robilkot/PhysPult/PhysPult_cad/Иллюстрации.pdf

# Общий вид конструкции

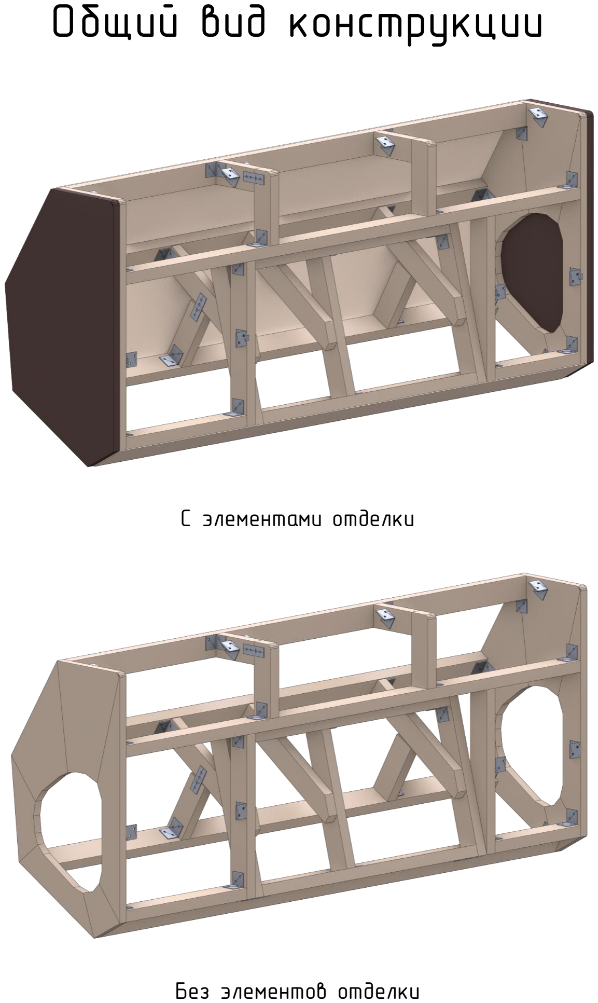
[picture p1: page 1]

С элементами отделки

Без элементов отделки

# Сборка конструкции

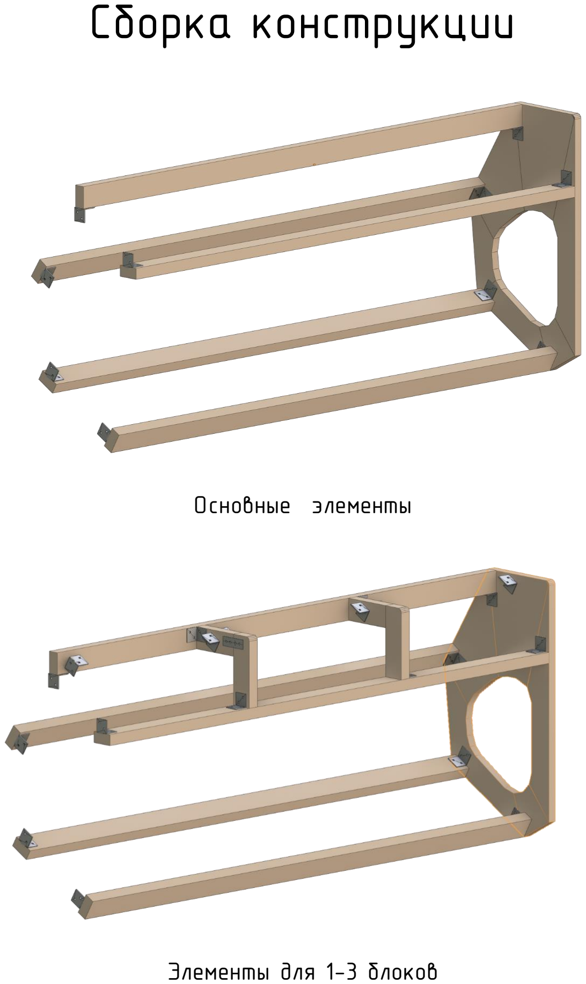
[picture p2: page 2]

Основные элементы

Элементы для 1-3 блоков

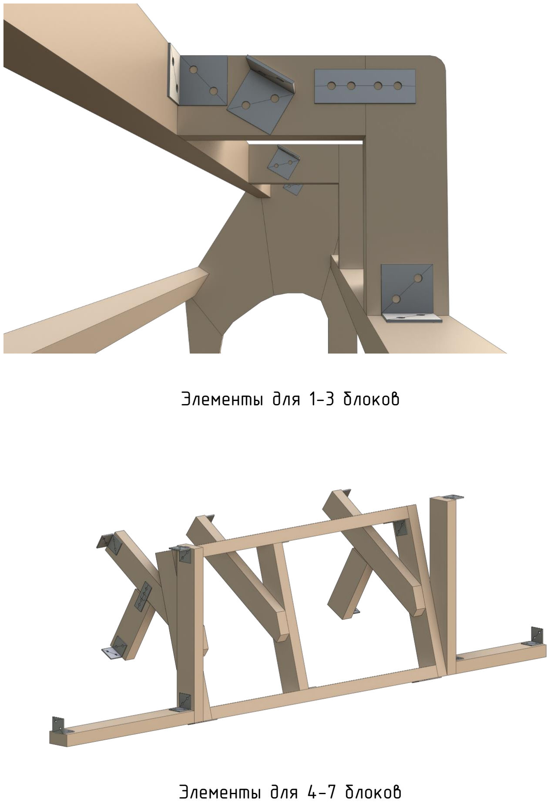
[picture p3: page 3]

Элементы для 1-3 блоков

Элементы для 4-7 блоков

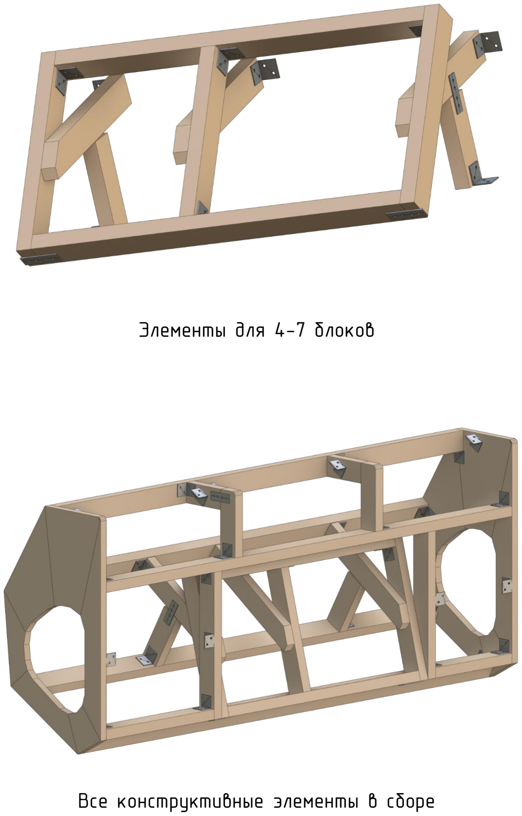
[picture p4: page 4]

Элементы для 4-7 блоков

Все конструктивные элементы в сборе
