robilkot/PhysPult/PhysPult_cad/Manometers.SLDPRT

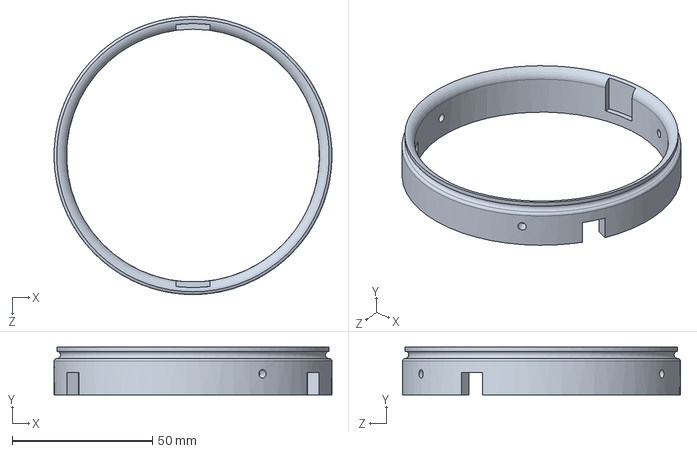
[picture p5: CAD file, 2023-04-17]
PhysPult_cad/Manometers.SLDPRT
99.0 x 17.0 x 99.0 mm
