robilkot/PhysPult/(list of files, cad)

Other CAD files:
PhysPult_cad/PhysPult_frame.blend
PhysPult_cad/PhysPult_manometers.blend
