robilkot/PhysPult/81-717.5_pult_cpp/81-717.5_pult_cpp_config.txt

C:\Program Files (x86)\Steam\steamapps\common\GarrysMod\garrysmod\data\lamps.txt
C:\Program Files (x86)\Steam\steamapps\common\GarrysMod\garrysmod\data\switches.txt
5
9600
