robilkot/PhysPult/(commit log)

2022-12-27 initial commit: arduino sketch, vs solution, table for matching indicators and pins
    [81-717.5_pult_cpp_config.txt, Таблица соответствия.xlsx]
2022-12-27 add SimpleSerial library, add notification about pause
    [syntax_config.txt]
2022-12-27 add arduino sketch
2022-12-27 move init to separate func, add configurable baud rate and frequency, remove enum, enhance arduino sketch
    [81-717.5_pult_cpp_config.txt]
2022-12-28 fix crash on meeting strings with unequal length
    [81-717.5_pult_cpp_config.txt]
2022-12-29 edit arduino sketch to work with registers. adapt c++ medium, refactor
2022-12-31 Оптимизация и рефакторинг кода микроконтроллера, дополнение таблицы соответствия
    [Таблица соответствия.xlsx]
2022-12-31 Реализована функция чтения значений с входных сдвиговых регистров
2023-01-01 Переход от инжектов к считыванию значений по таймеру. Оптимизация, рефакторинг
2023-01-01 Добавлено считывание состояний переключателей из файла. Изменена таблица соответствия
    [Таблица соответствия.xlsx]
2023-01-01 Реализована функция записи состояния переключателей в файл. Изменен формат конфига
    [81-717.5_pult_cpp_config.txt, syntax_config.txt]
2023-01-02 Рефакторинг, синхронизация состояний тумблеров, разделение таблиц кнопок и тумблеров
2023-01-02 Длины строк состояния вынесены в конфиг-файл, возможность задавать собственный конфиг-файл как аргумент при запуске программы
    [physpult_config.txt]
2023-01-02 Изменена структура проекта
    [mappingTable.xlsx, physpult_config.txt, syntax_config.txt]
2023-01-03 Прошивка теперь позволяет подключать регистры к цифровым пинам 1-7
2023-01-03 Рефакторинг
2023-01-04 Добавлена горячая перезагрузка и налажен приём данных с ардуино
    [physpult_config.txt]
2023-01-04 Улучшена горячая перезагрузка
    [physpult_config.txt]
2023-01-05 Наладка отправки данных в обе стороны
2023-01-08 Реализована передача информации по сокетам. Изменен формат конфига.
    [physpult_config.txt]
2023-01-10 Отлажена передача данных по сокетам, рефакторинг
    [physpult_config.txt]
2023-01-17 Рефакторинг, костыль решающий потерянные пакеты на начале работы серийного порта
    [physpult_config.txt]
2023-01-18 Добавлена возможность ставить таймаут приема по серийному порту в миллисекундах. Рефакторинг библиотеки для серийного порта
2023-01-31 Реализован асинхронный приём данных по COM порту
2023-01-31 Незначительные исправления
    [syntax_config.txt]
2023-01-31 Реализована многопоточность для сокетов и серийного порта. Чтение конфига скриптом луа
    [physpult_config.txt]
2023-02-04 Переподключение сокета в случае ошибки
    [physpult_config.txt]
2023-02-04 Передел под ООП
2023-02-07 Исправлены ошибки подключения, связанные с инициализацией объектов SimpleSerial и TcpClient
    [main.cpp]
2023-02-07 Решены проблемы при горячей перезагрузке конфига
2023-02-07 Решены проблемы длины передаваемых строк
2023-03-18 Коробка электрики
    [PhysPult_frame.blend]
2023-04-01 Начата кодировка
    [physpult_config.txt]
2023-04-01 Связь стабильнее
    [PhysPult_frame.blend, physpult_config.txt]
2023-04-02 Кодировка
2023-04-02 Доделал передачу, временно через файлы
2023-04-04 Связь по сокетам
    [physpult_config.txt]
2023-04-04 Микрофиксы
    [physpult_config.txt]
2023-04-04 Фикс сокетов. но временный
2023-04-17 Детали в CAD
    [Manometers.SLDPRT, PhysPult_manom.blend]
2023-04-20 Манометры в блендере
    [PhysPult_manom.blend, PhysPult_manometers.blend]
2023-04-21 Финальная модель манометра ТЦ
    [PhysPult_manometers.blend]
2023-05-25 Детали для 3д печати, программные доработки, обработка 165 регистров
    [PhysPult_manometers.blend, physpult_config.txt]
2023-05-28 Протокол связи изменен. Скорость передается одним байтом уже из луа, а также в начало строки состояния добавлены вольтметр и манометры
    [mappingTable.xlsx, physpult_config.txt]
2023-05-29 Переход от директив к параметрам в конфиге
2023-06-04 Переход от библиотеки fastled на microled (исправлена ШИМ для сервоприводов)
2023-06-04 Переход от директив define к флагам в текстовом конфиге
    [physpult_config.txt]
2023-06-05 Сокращение использования памяти, переход на таймеры библиотеки TimerMs, переход на управление сервоприводом через библиотеку ServoSmooth для уменьшения износа механики
2023-08-16 Рефакторинг, фикс индексов ламп
2023-11-08 Удалены лишние зависимости, отладка сервоприводов
    [PhysPult_manometers.blend, physpult_config.txt]
2023-12-26 Migrating to esp32. State machine, multi-core communicatio and hardware functions. Websockets communication
2024-01-21 Support for ampermeter and kVoltmeter
    [PhysPult_frame.blend]
2024-12-29 Fixes, updated docs, new stand for pult and kv
    [PhysPult_manometers.blend]
2025-01-16 New frame
2025-01-17 Fix docs, imrpove lua
    [Hardware.h, Pult.h, main.cpp]
2025-01-19 Concurrency fix; implement pult lighting
    [Hardware.h, Pult.cpp, Pult.h, main.cpp]
2025-01-20 OE pin coded
2025-01-20 Event-driven design for communication on esp side
    [PhysPult_manometers.blend]
2025-01-21 Fix init for monitor
    [Pult.cpp]
2025-01-22 Feature flags on lua side; fix starvation of communicator
    [PhysPult_manometers.blend]
2025-01-25 New manometers mount model
    [PhysPult_manometers.blend]
2025-01-26 Mount for din connectors
    [PhysPult_manometers.blend]
2025-01-27 Fixes to mapping; revive door buttons
2025-01-29 Fix memory usage with pointers; start implementing serial communication
    [Pult.cpp, SerialCommunicator.cpp, SerialCommunicator.h]
2025-01-30 Fix PDU for serial communication
    [SerialCommunicator.cpp, SerialCommunicator.h, SerialCommunicatorMessage.h]
2025-02-02 Mount for electronics
